SloeComputers/picoX7/docs/Schematics/WAVESHARE_REV2_1/picoX7_WAVESHARE_REV2_1.kicad_sch

## KiCad design docs/Schematics/WAVESHARE_REV2_1/picoX7_WAVESHARE_REV2_1.kicad_sch (2026-03-08)

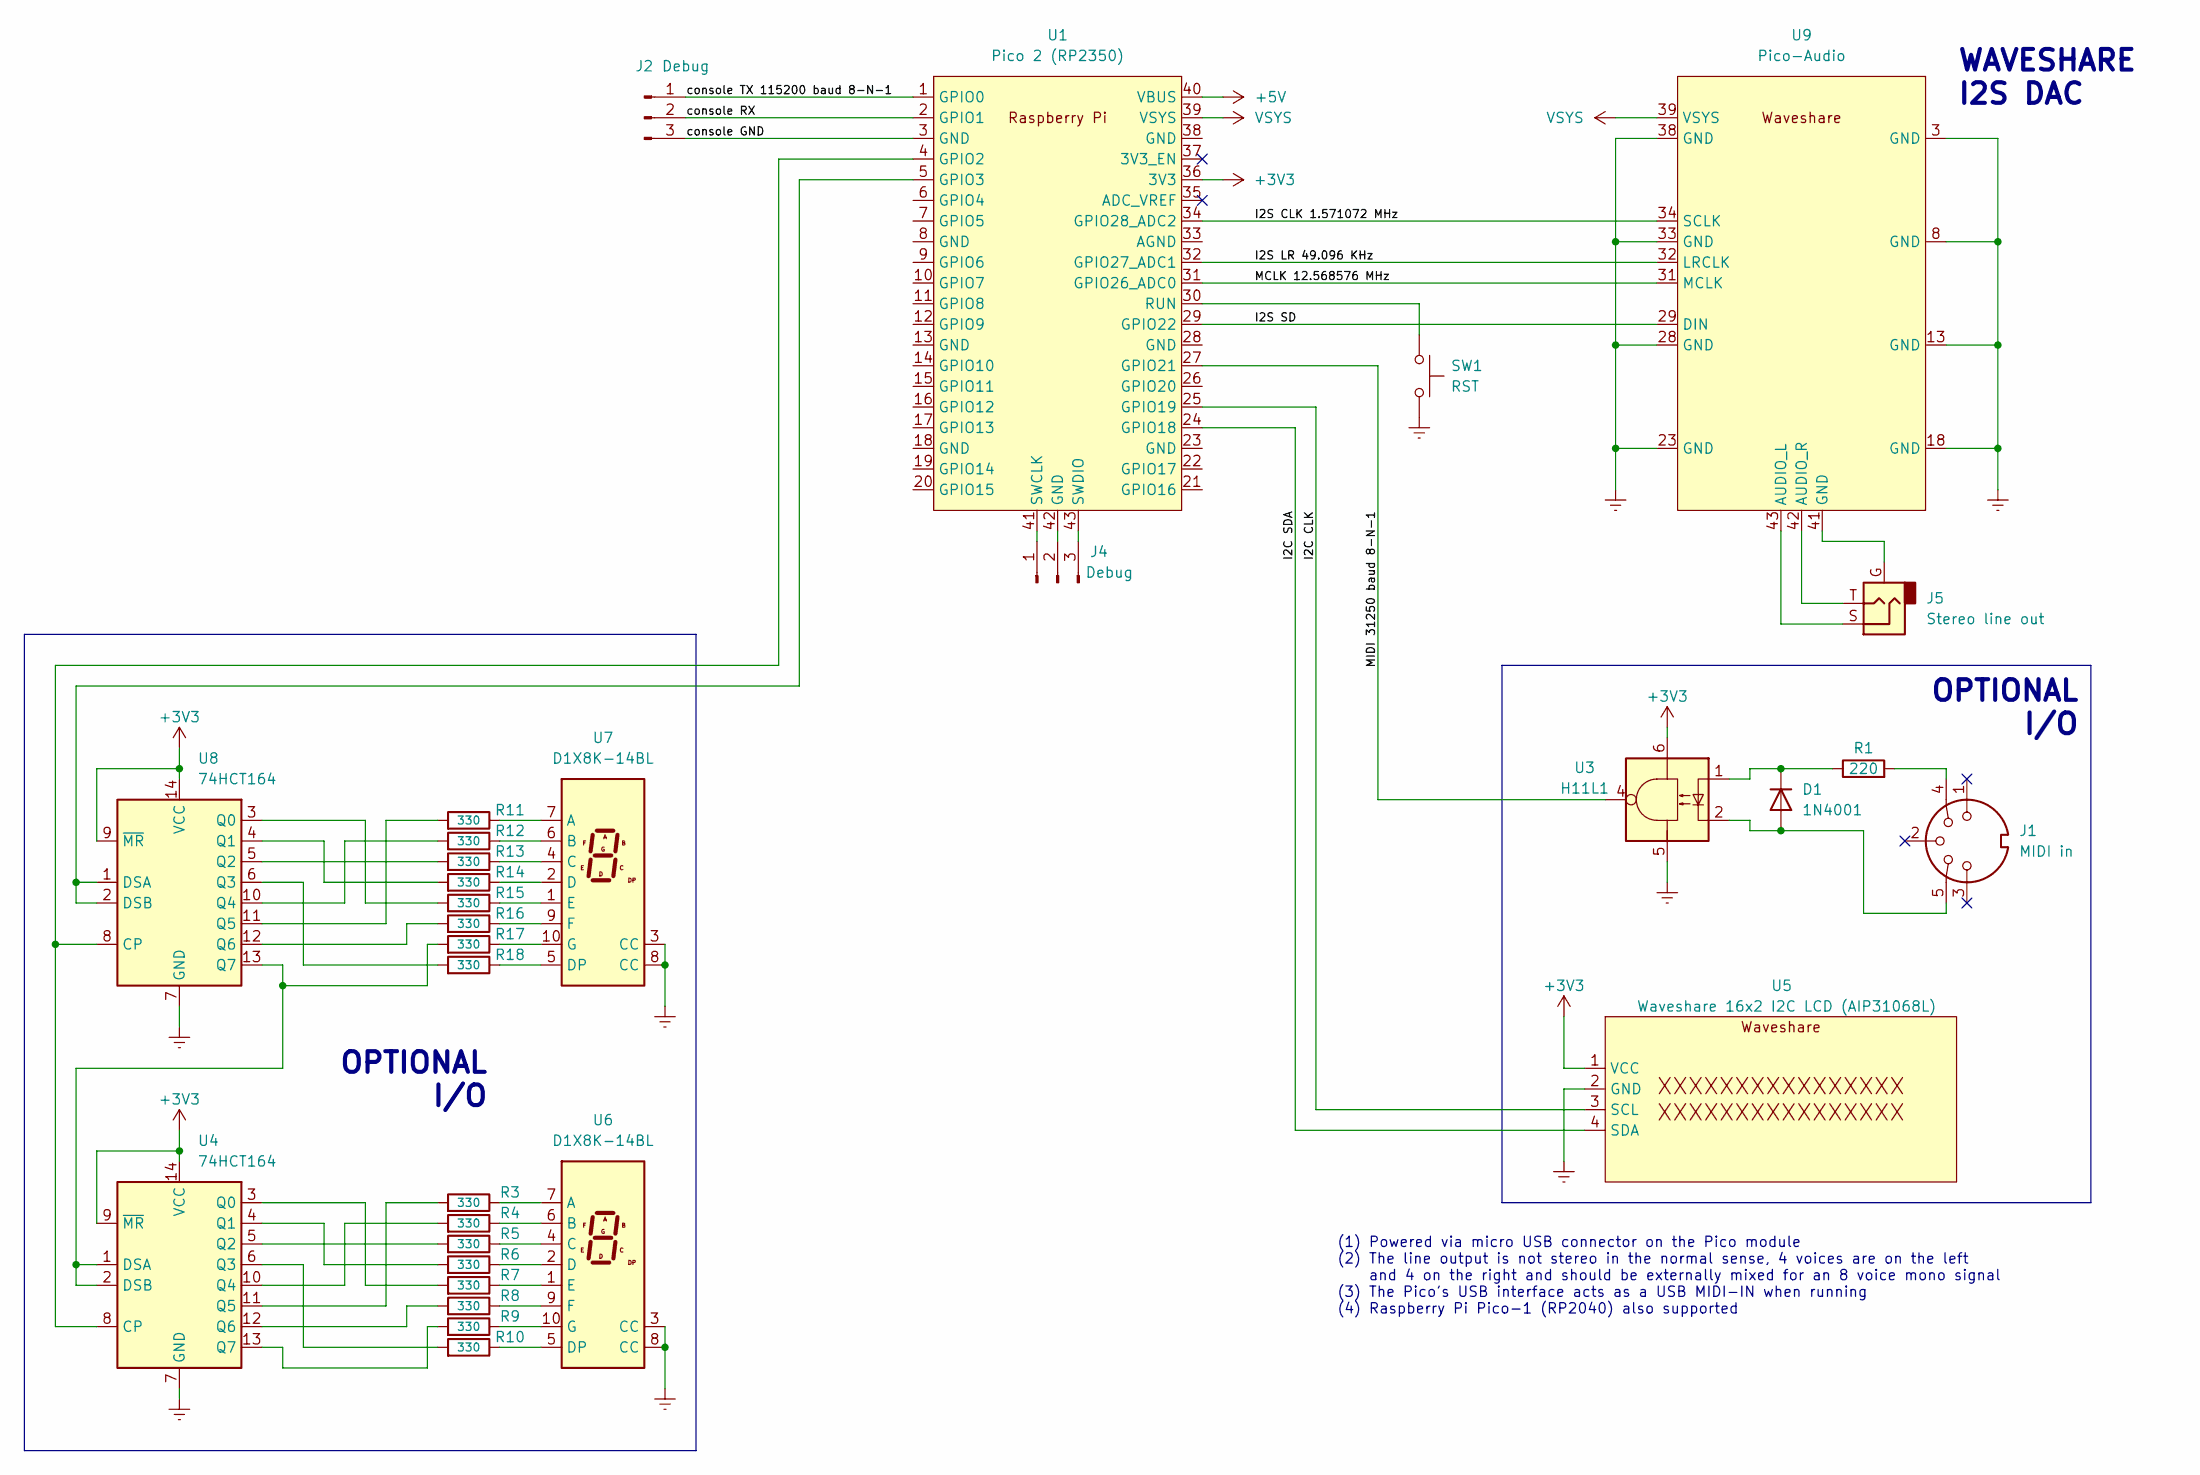
[picture p2: schematic picoX7_WAVESHARE_REV2_1.kicad_sch]

Parts:
D1: 1N4001; D_DO-41_SOD81_P10.16mm_Horizontal
J1: MIDI in
J2, J4: Debug; FanPinHeader_1x03_P2.54mm_Vertical
J5: Stereo line out; Jack_3.5mm_CUI_SJ1-3523N_Horizontal
R1: 220; R_Axial_DIN0204_L3.6mm_D1.6mm_P5.08mm_Horizontal
R3, R4, R5, R6, R7, R8, R9, R10, R11, R12, R13, R14, R15, R16, R17, R18: 330; R_Axial_DIN0204_L3.6mm_D1.6mm_P5.08mm_Horizontal
SW1: RST; SW_PUSH_6mm_H5mm
U1: Pico 2 (RP2350); RPi_Pico_SMD_TH
U3: H11L1; DIP-6_W7.62mm_LongPads
U4, U8: 74HCT164
U5: Waveshare 16x2 I2C LCD (AIP31068L); RPi_Pico_SMD_TH
U6, U7: D1X8K-14BL; D1X8K
U9: Pico-Audio; RPi_Pico_SMD_TH

Connections:
+3V3: U1.36 (3V3), U3.6, U4.9 (~MR), U4.14 (VCC), U5.1 (VCC), U8.9 (~MR), U8.14 (VCC)
+5V: U1.40 (VBUS)
Earth: SW1.2, U3.5, U4.7 (GND), U5.2 (GND), U6.3 (CC), U6.8 (CC), U7.3 (CC), U7.8 (CC), U8.7 (GND), U9.3 (GND), U9.8 (GND), U9.13 (GND), U9.18 (GND), U9.23 (GND), U9.28 (GND), U9.33 (GND), U9.38 (GND)
I2C CLK: U1.25 (GPIO19), U5.3 (SCL)
I2C SDA: U1.24 (GPIO18), U5.4 (SDA)
I2S CLK 1.571072 MHz: U1.34 (GPIO28_ADC2), U9.34 (SCLK)
I2S LR 49.096 KHz: U1.32 (GPIO27_ADC1), U9.32 (LRCLK)
I2S SD: U1.29 (GPIO22), U9.29 (DIN)
MCLK 12.568576 MHz: U1.31 (GPIO26_ADC0), U9.31 (MCLK)
MIDI 31250 baud 8-N-1: U1.27 (GPIO21), U3.4
unnamed: D1.1 (K), R1.1, U3.1
unnamed: D1.2 (A), J1.5, U3.2
unnamed: J1.4, R1.2
unnamed: J4.1, U1.41 (SWCLK)
unnamed: J4.2, U1.42 (GND)
unnamed: J4.3, U1.43 (SWDIO)
unnamed: J5.G, U9.41 (GND)
unnamed: J5.S, U9.43 (AUDIO_L)
unnamed: J5.T, U9.42 (AUDIO_R)
unnamed: R3.1, U6.7 (A)
unnamed: R3.2, U4.11 (Q5)
unnamed: R4.1, U6.6 (B)
unnamed: R4.2, U4.10 (Q4)
unnamed: R5.1, U6.4 (C)
unnamed: R5.2, U4.5 (Q2)
unnamed: R6.1, U6.2 (D)
unnamed: R6.2, U4.4 (Q1)
unnamed: R7.1, U6.1 (E)
unnamed: R7.2, U4.3 (Q0)
unnamed: R8.1, U6.9 (F)
unnamed: R8.2, U4.12 (Q6)
unnamed: R9.1, U6.10 (G)
unnamed: R9.2, U4.13 (Q7)
unnamed: R10.1, U6.5 (DP)
unnamed: R10.2, U4.6 (Q3)
unnamed: R11.1, U7.7 (A)
unnamed: R11.2, U8.11 (Q5)
unnamed: R12.1, U7.6 (B)
unnamed: R12.2, U8.10 (Q4)
unnamed: R13.1, U7.4 (C)
unnamed: R13.2, U8.5 (Q2)
unnamed: R14.1, U7.2 (D)
unnamed: R14.2, U8.4 (Q1)
unnamed: R15.1, U7.1 (E)
unnamed: R15.2, U8.3 (Q0)
unnamed: R16.1, U7.9 (F)
unnamed: R16.2, U8.12 (Q6)
unnamed: R17.1, U7.10 (G)
unnamed: R17.2, U4.1 (DSA), U4.2 (DSB), U8.13 (Q7)
unnamed: R18.1, U7.5 (DP)
unnamed: R18.2, U8.6 (Q3)
unnamed: SW1.1, U1.30 (RUN)
unnamed: U1.4 (GPIO2), U4.8 (CP), U8.8 (CP)
unnamed: U1.5 (GPIO3), U8.1 (DSA), U8.2 (DSB)
VSYS: U1.39 (VSYS), U9.39 (VSYS)
console GND: J2.3, U1.3 (GND)
console RX: J2.2, U1.2 (GPIO1)
console TX 115200 baud 8-N-1: J2.1, U1.1 (GPIO0)

Notes on the sheet:
OPTIONAL I/O
(1) Powered via micro USB connector on the Pico module (2) The line output is not stereo in the normal sense, 4 voices are on the left and 4 on the right and should be externally mixed for an 8 voice mono signal (3) The Pico's USB interface acts as a USB MIDI-IN when running (4) Raspberry Pi Pico-1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
WAVESHARE I2S DAC
