SloeComputers/picoX7/(commit log)

2026-03-08 Rename git account SloeComputers
    [picoX7.kicad_sch, picoX7_WAVESHARE_REV2_1.kicad_sch]
2026-04-26 Switch to matrix build for MTL targets
2026-05-05 Update PDK to fix printf/sprintf bug
2026-06-14 Quick fix for sample rate issue in VST3 plugin + better quality fix to follow
2026-06-28 Move MIDI processing to audio "thread"
